hbiedka/diy_iot_nixie_clock_ntp/images/painting.jpg

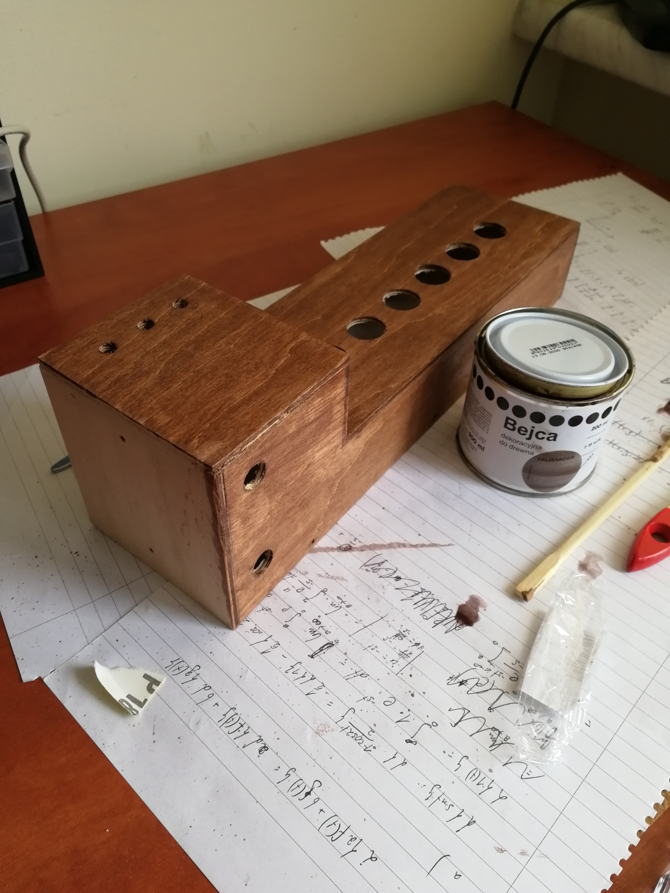
images/painting.jpg
