hbiedka/diy_iot_nixie_clock_ntp/images/woodwork2.jpg

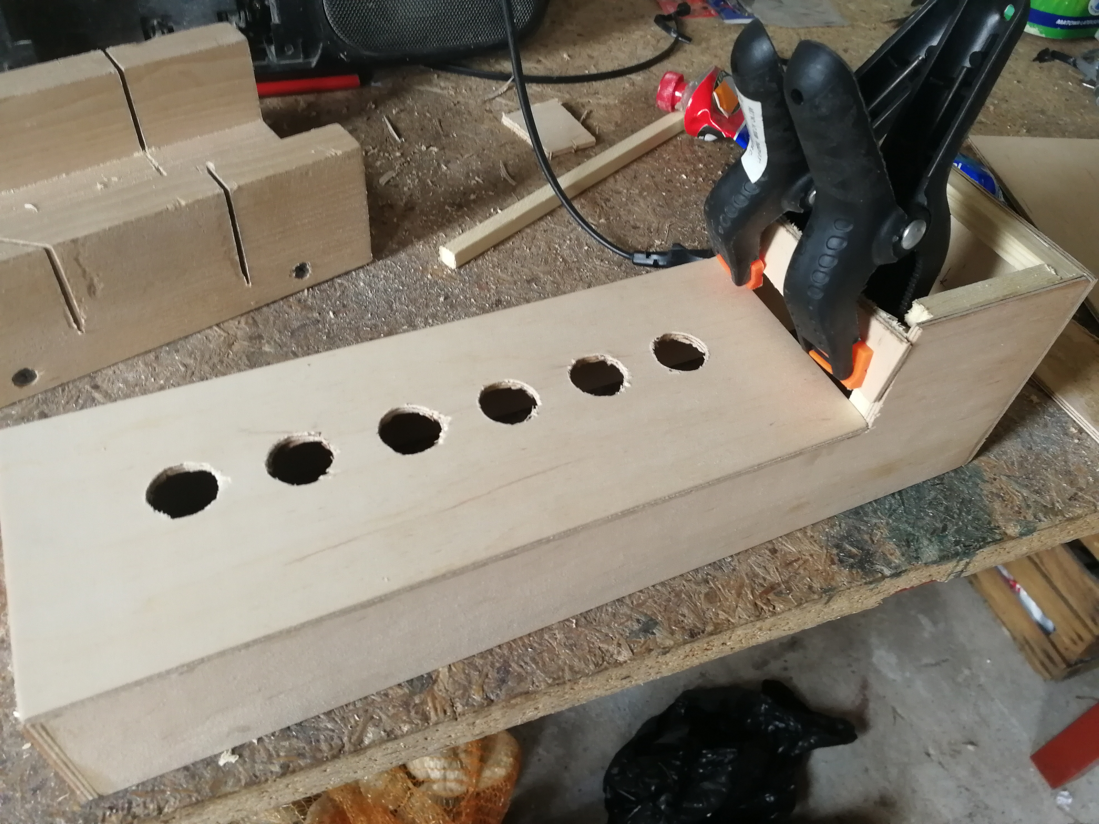
images/woodwork2.jpg
