hbiedka/diy_iot_nixie_clock_ntp/(commit log)

2023-01-14 Removed debug serial prints
2023-01-14 Added schematics
2023-02-12 Added arduino fitted ino file
2023-07-05 Removed serial prints and added debug mode
2023-07-08 fixed no newline on UART. sent ti? when connected
    [nixie.ino]
